heqichen/qc40/structure/shell/process1.png

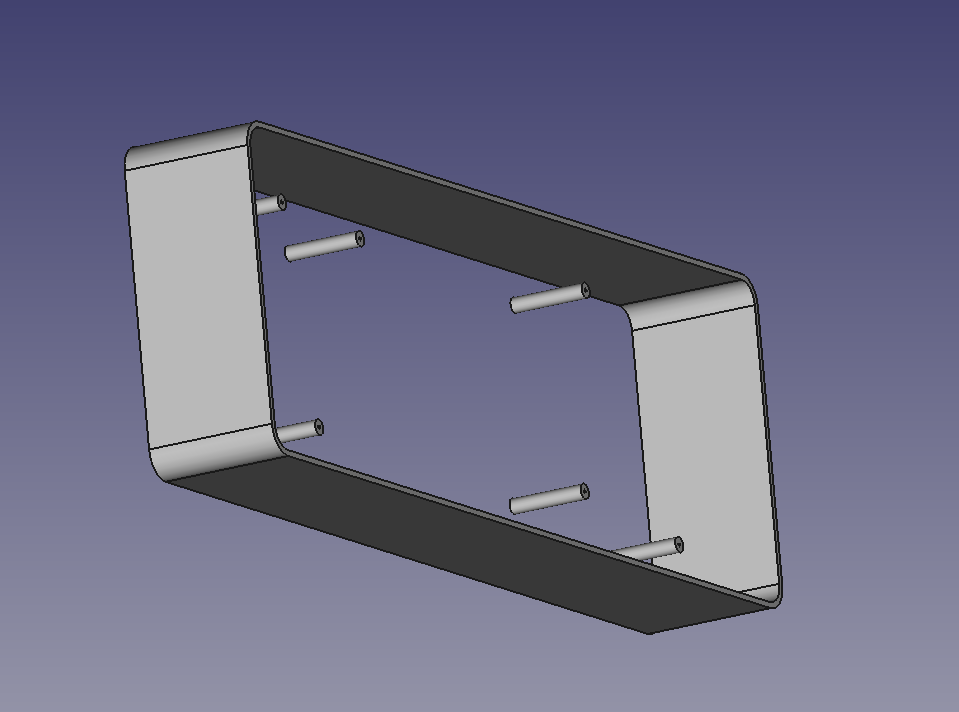
structure/shell/process1.png
