heqichen/qc40/andon/README.md

1. #1 can transmit message and print what transitted
2. #0 can receive data and check what received
