heqichen/qc40/document/usbdacpcm2704sch.png

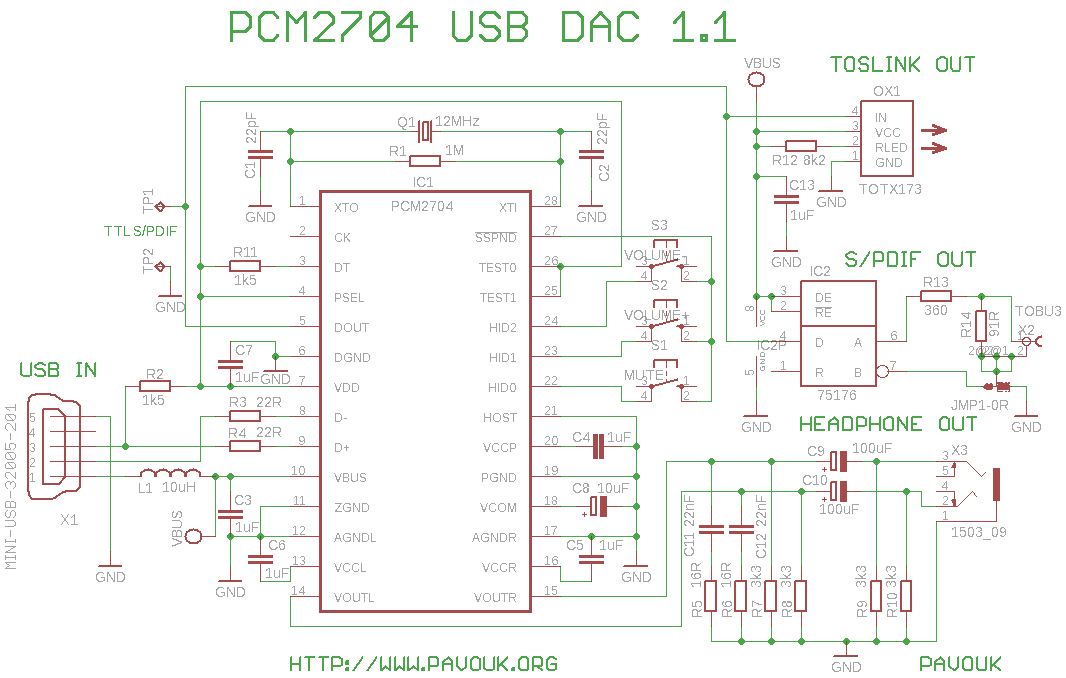
document/usbdacpcm2704sch.png
