heqichen/qc40/document/y2JtpHl.png

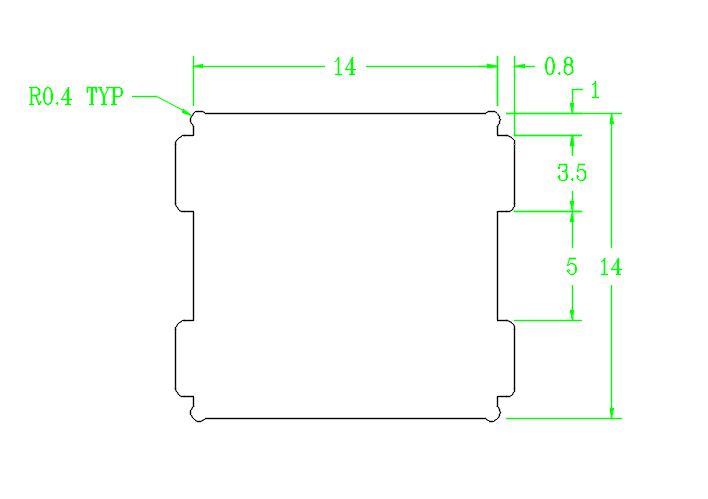
document/y2JtpHl.png
