heqichen/qc40/tu40.png

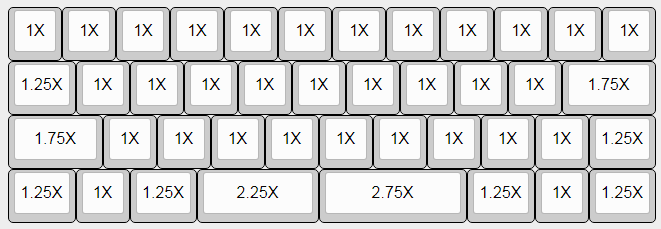
tu40.png
