heqichen/qc40/structure/shell.dxf

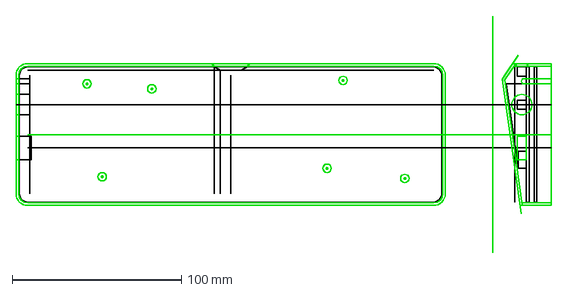
[picture p8: CAD file, 2018-02-18]
structure/shell.dxf
316.5 x 140.0 mm
