heqichen/qc40/structure/shell/shell.fcstd

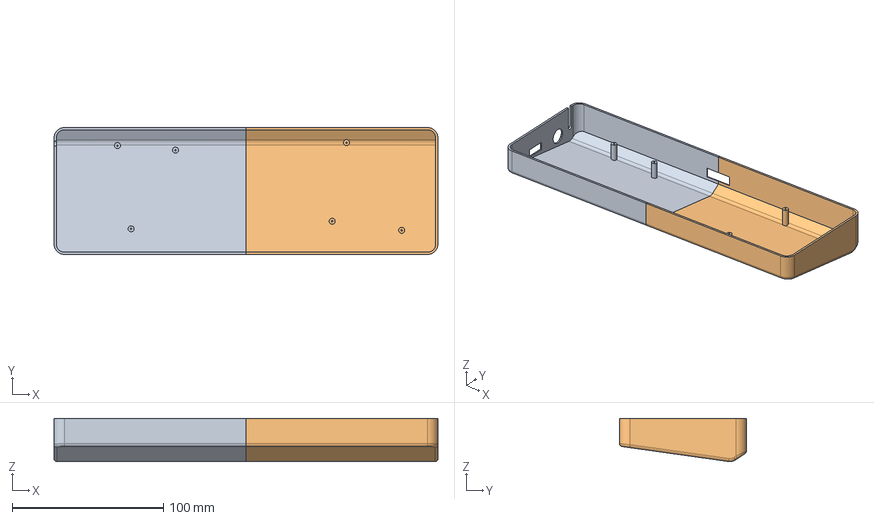
[picture p9: CAD file, 2018-02-18]
structure/shell/shell.fcstd
254.0 x 84.0 x 28.6 mm
shell-left
shell-right
