heqichen/qc40/structure/print-20170824.dxf

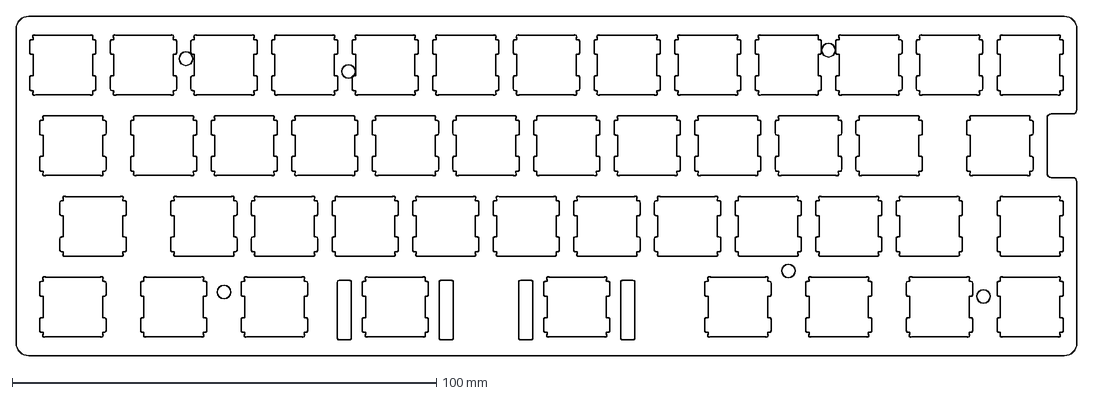
[picture p10: CAD file, 2017-09-01]
structure/print-20170824.dxf
250.0 x 80.0 mm
