heqichen/qc40/structure/h4k1.dxf

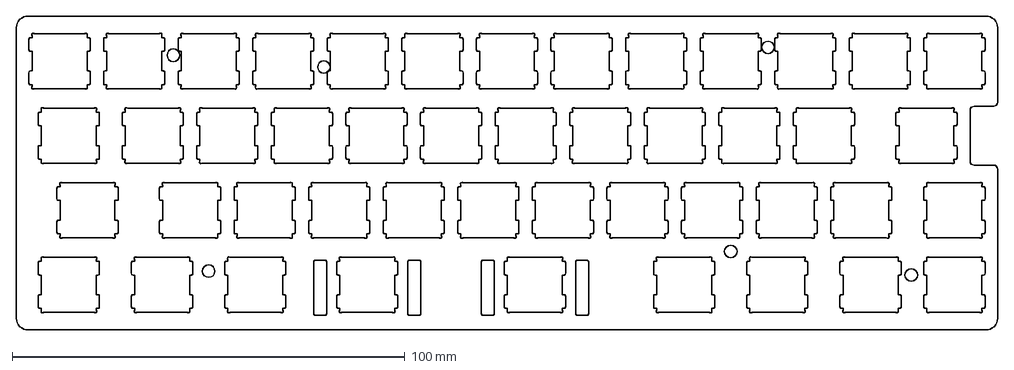
[picture p11: CAD file, 2017-08-23]
structure/h4k1.dxf
250.0 x 80.0 mm
