heqichen/qc40/structure/shell/shell-backup1.fcstd

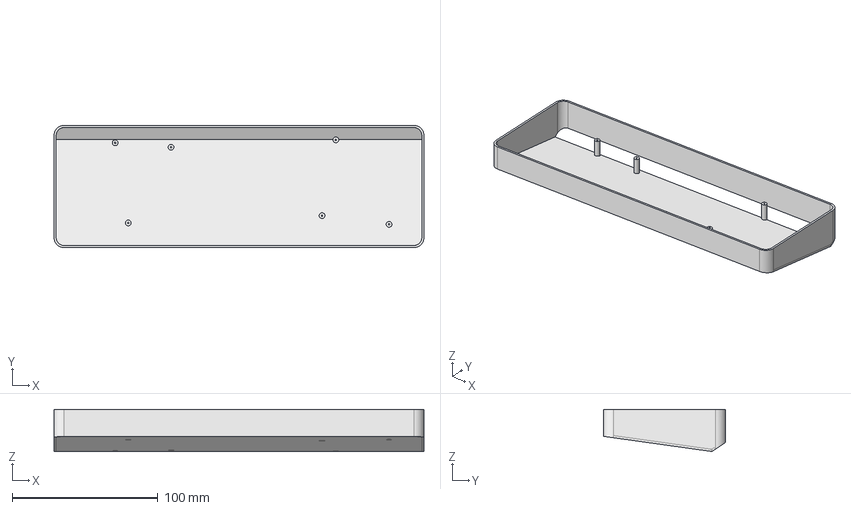
[picture p12: CAD file, 2018-02-18]
structure/shell/shell-backup1.fcstd
254.0 x 84.0 x 28.9 mm
