heqichen/qc40/structure/shell/shell-backup4.fcstd

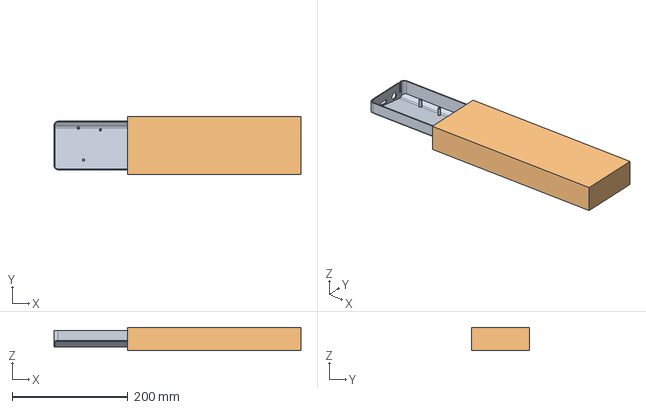
[picture p13: CAD file, 2018-02-18]
structure/shell/shell-backup4.fcstd
427.0 x 100.0 x 40.0 mm
