heqichen/qc40/structure/shell/shell-left.stl

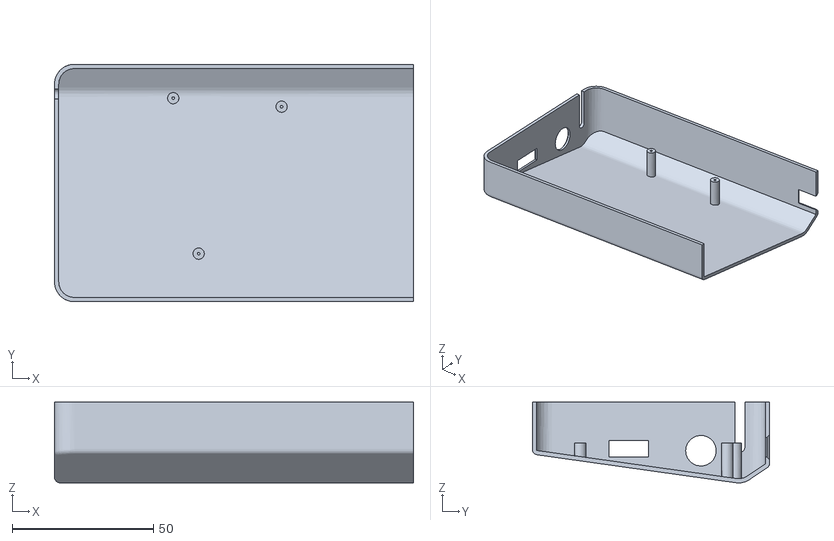
[picture p14: CAD file, 2018-02-18]
structure/shell/shell-left.stl
127.0 x 84.0 x 28.6
