heqichen/qc40/structure/shell/shell-backup5.fcstd

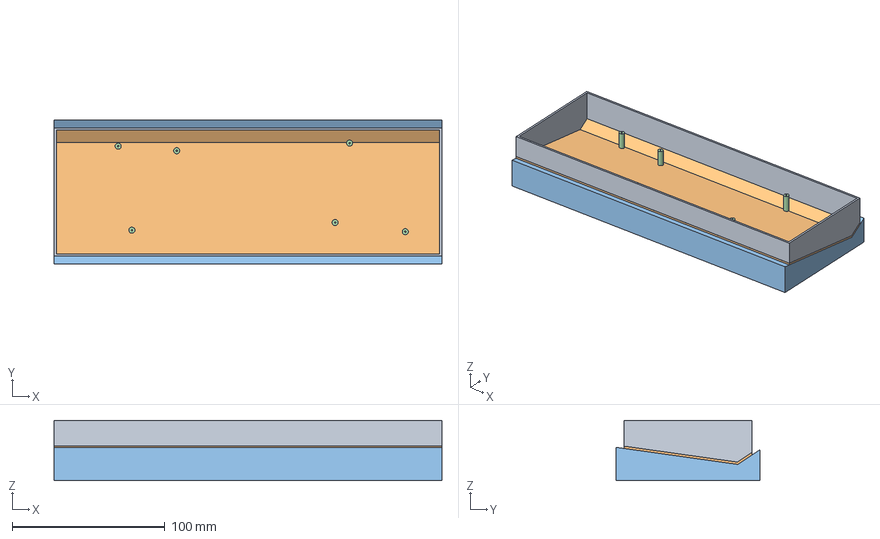
[picture p15: CAD file, 2018-02-18]
structure/shell/shell-backup5.fcstd
254.0 x 94.0 x 39.5 mm
外框Pad
大底pad
底阴模pad
