heqichen/qc40/(list of files, cad)

Other CAD files:
structure/shell/shell-backup3.fcstd
structure/shell/shell-backup2.fcstd
structure/shell/shell-right.stl
structure/shell/shell-backup6.fcstd
structure/shell/shell.stl
