heqichen/qc40/h4k1/h4k1.brd

## EAGLE design h4k1/h4k1.brd (2017-08-19)

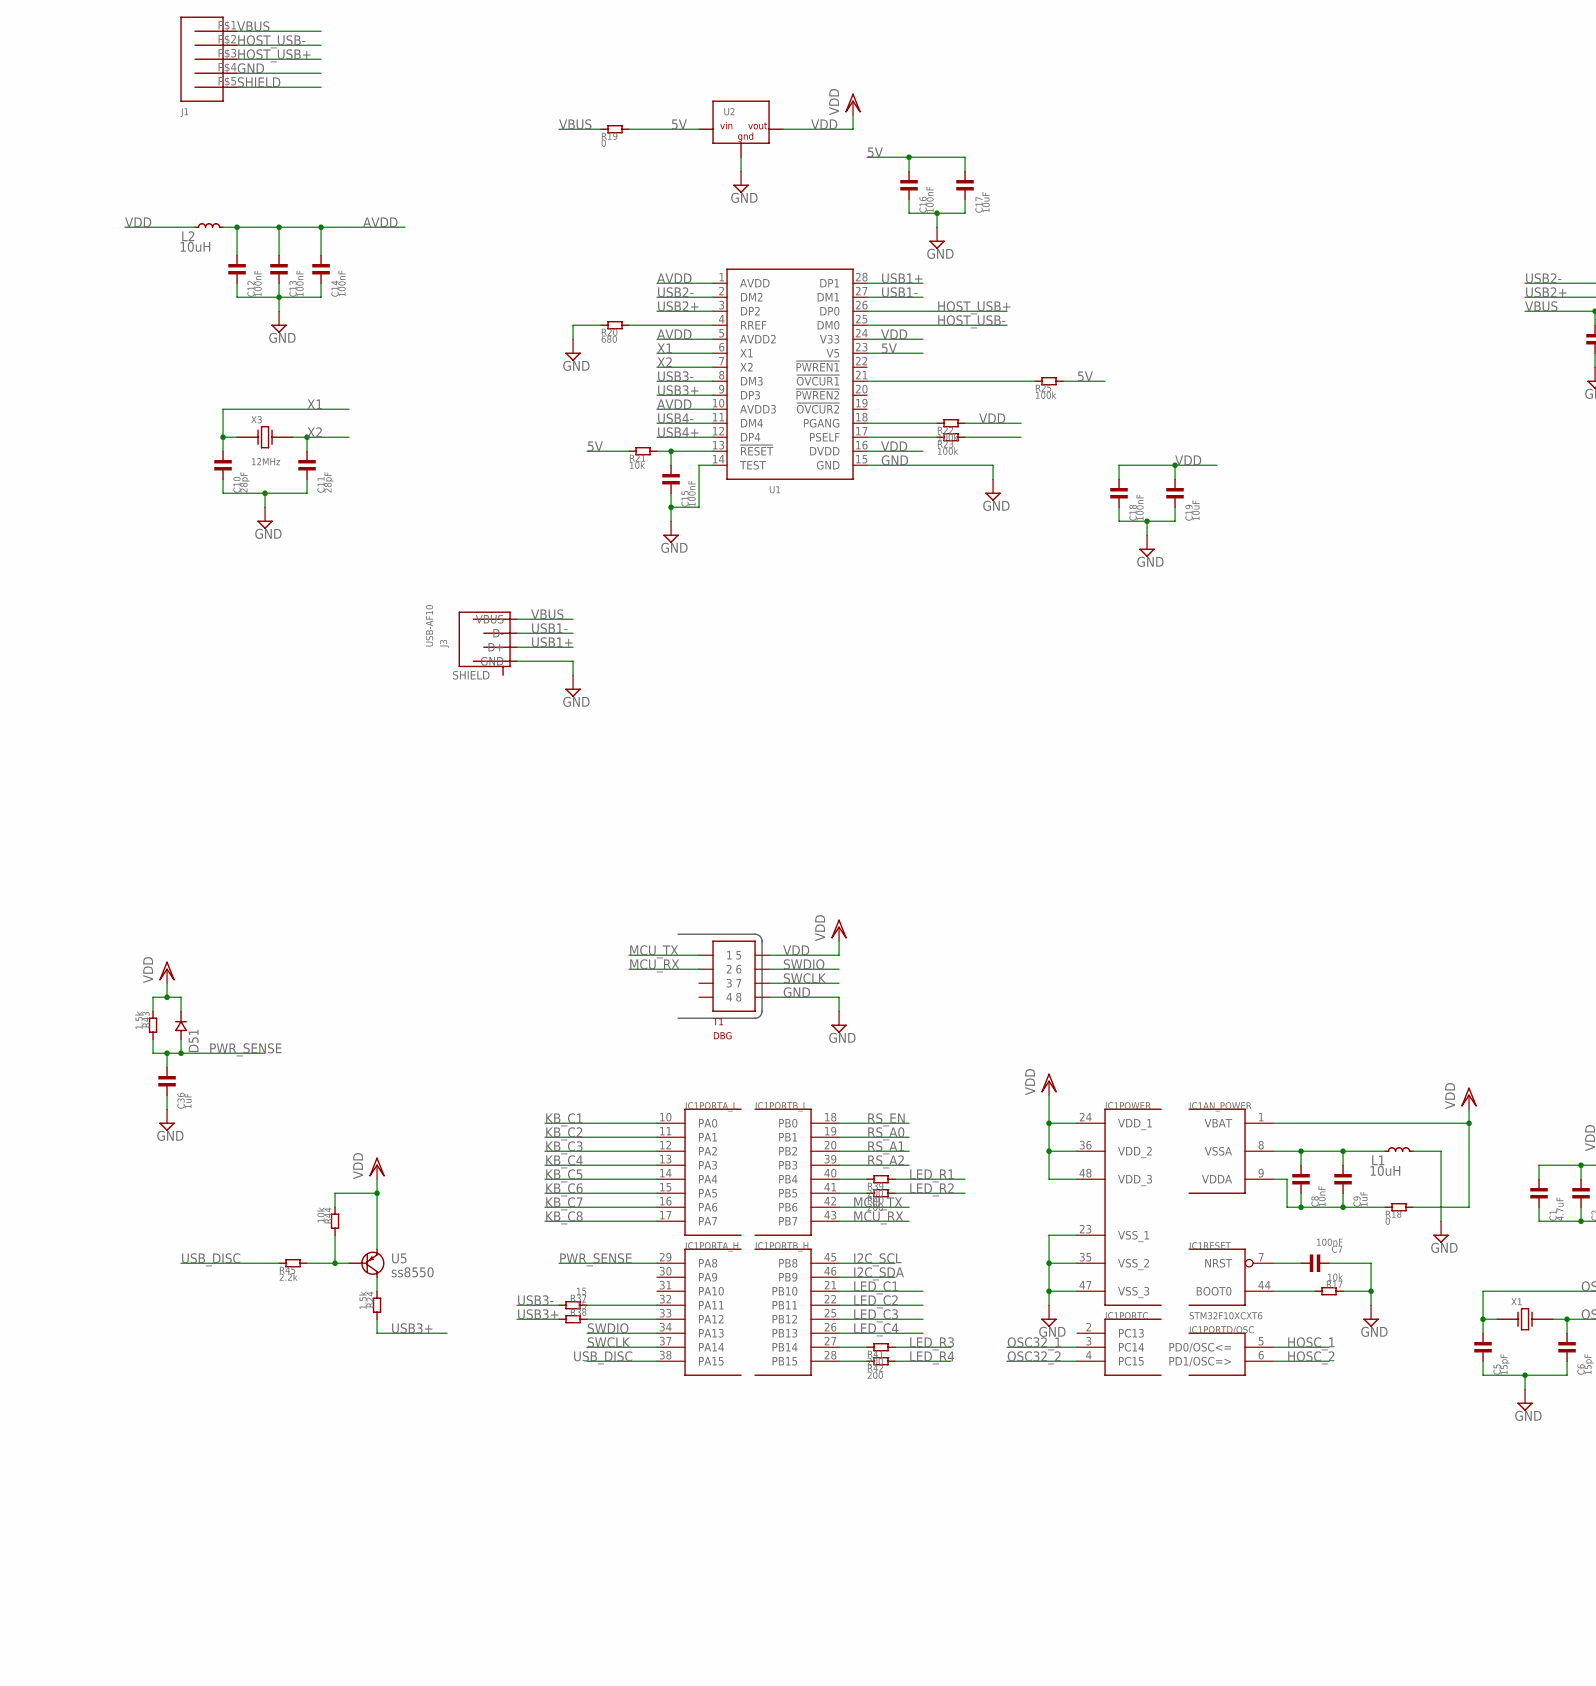
[picture p16: schematic h4k1.sch, part in row 1, column 1]

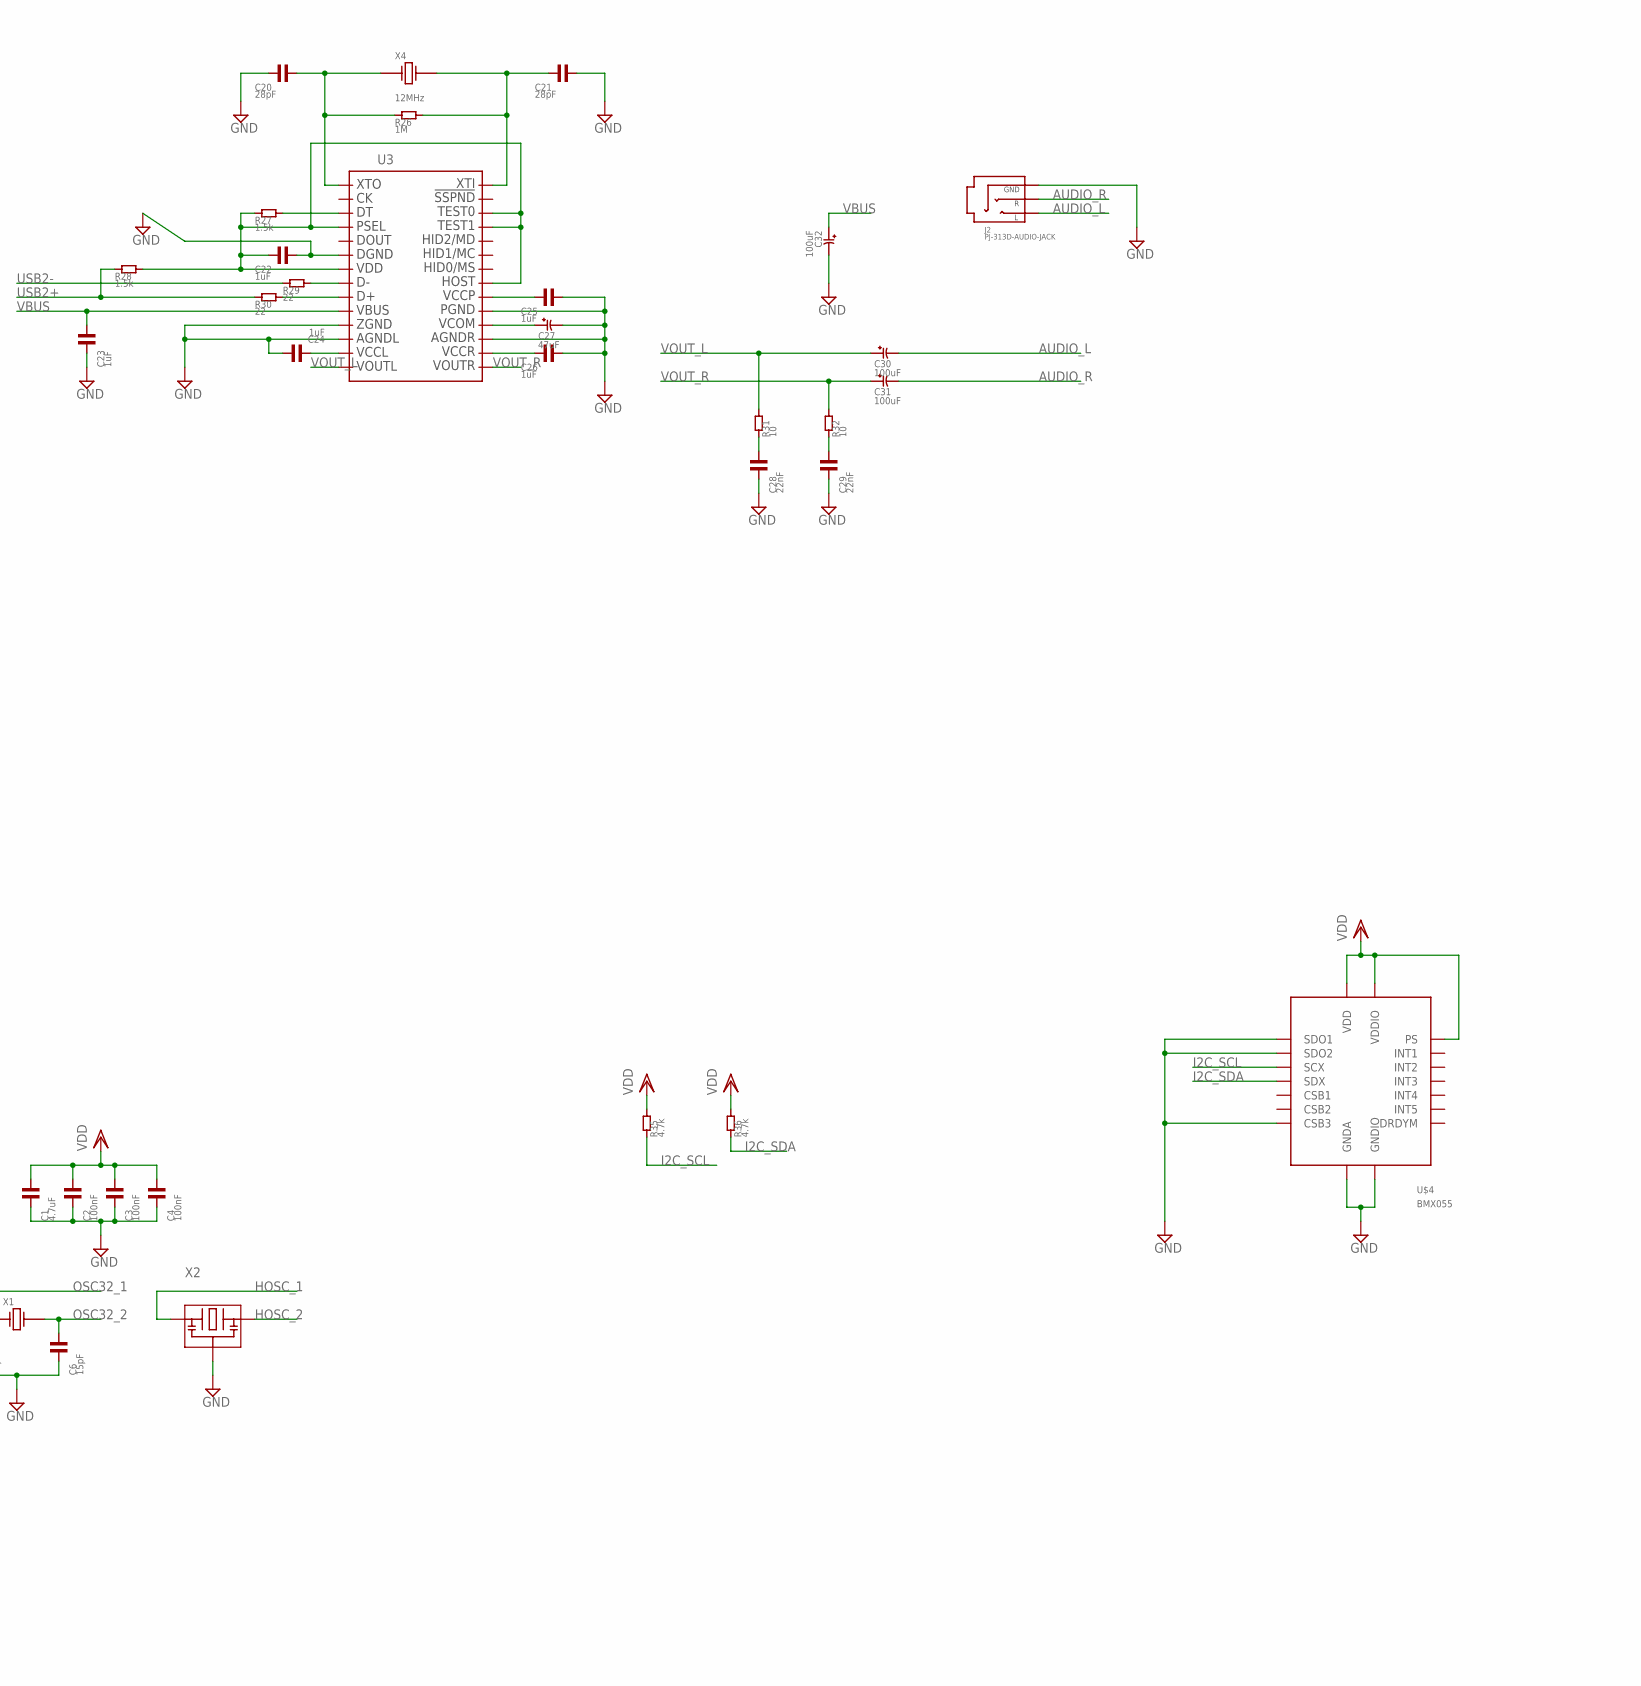
[picture p17: schematic h4k1.sch, part in row 1, column 2]

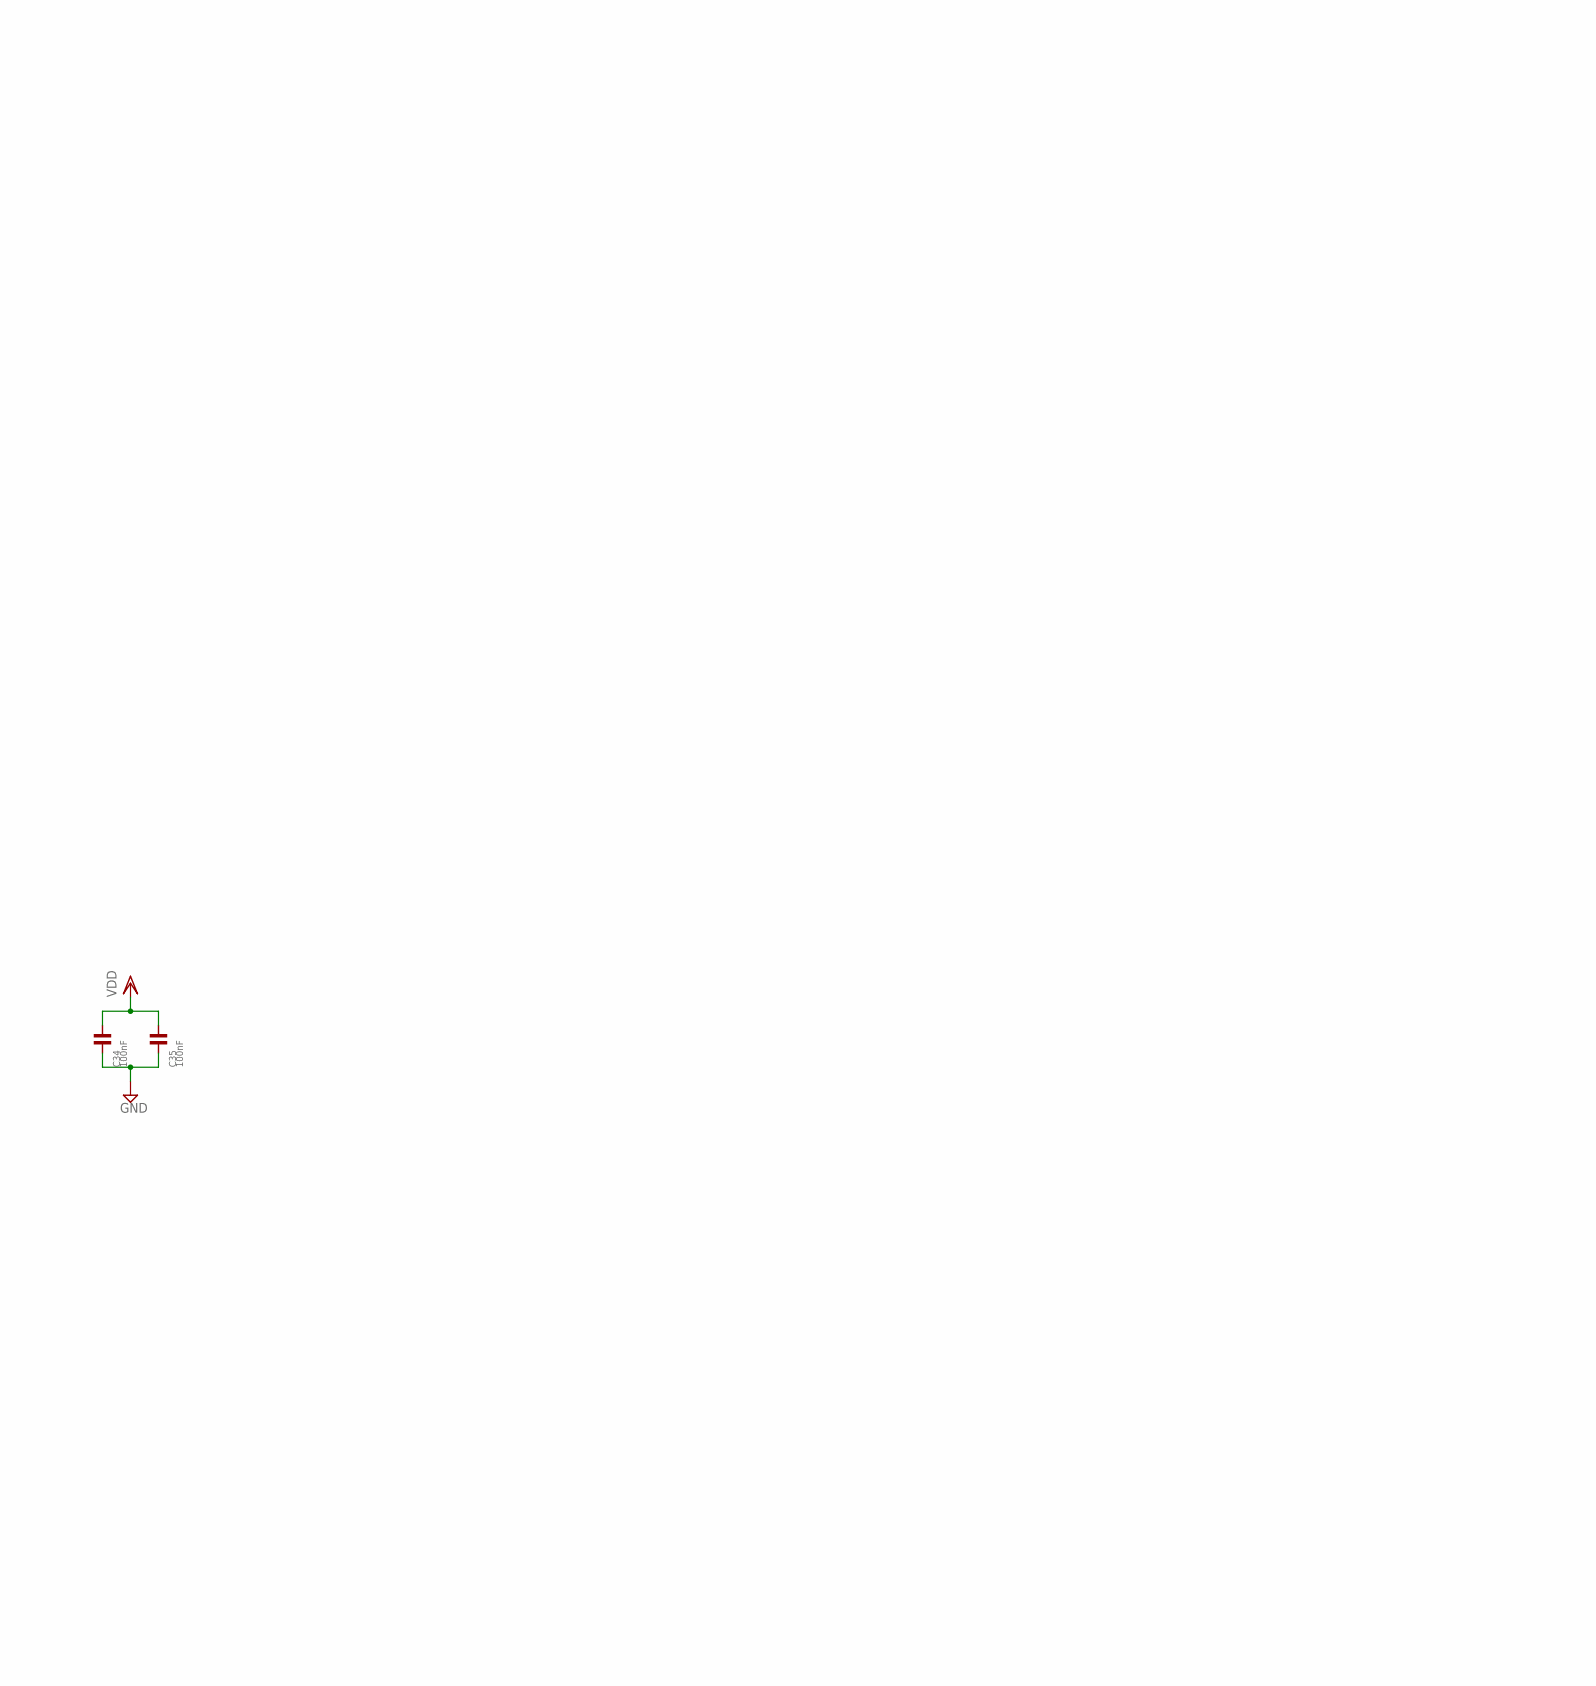
[picture p18: schematic h4k1.sch, part in row 1, column 3]

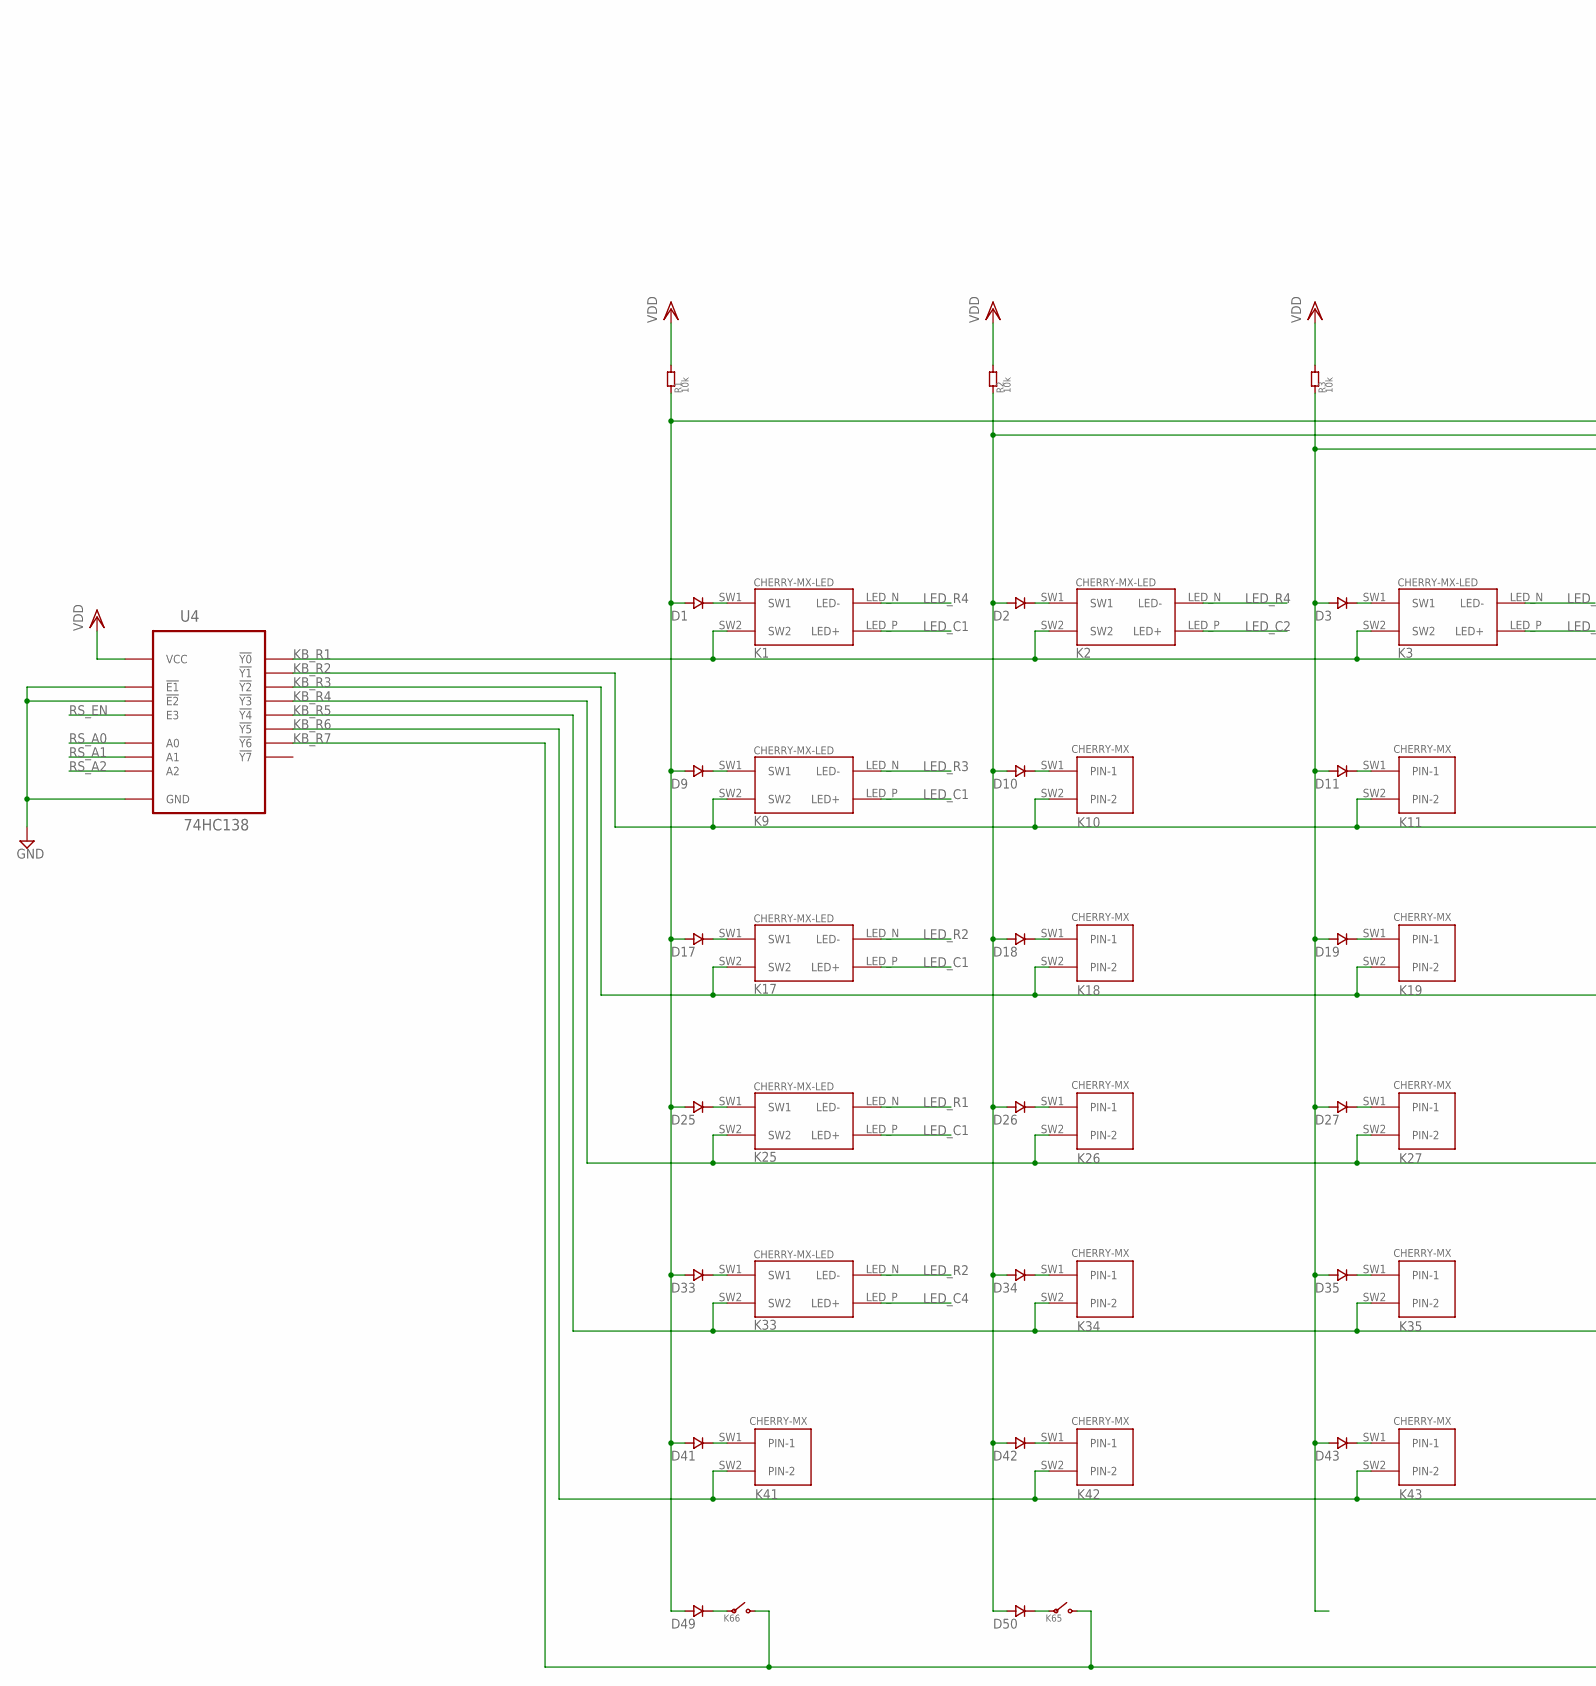
[picture p19: schematic h4k1.sch, part in row 2, column 1]

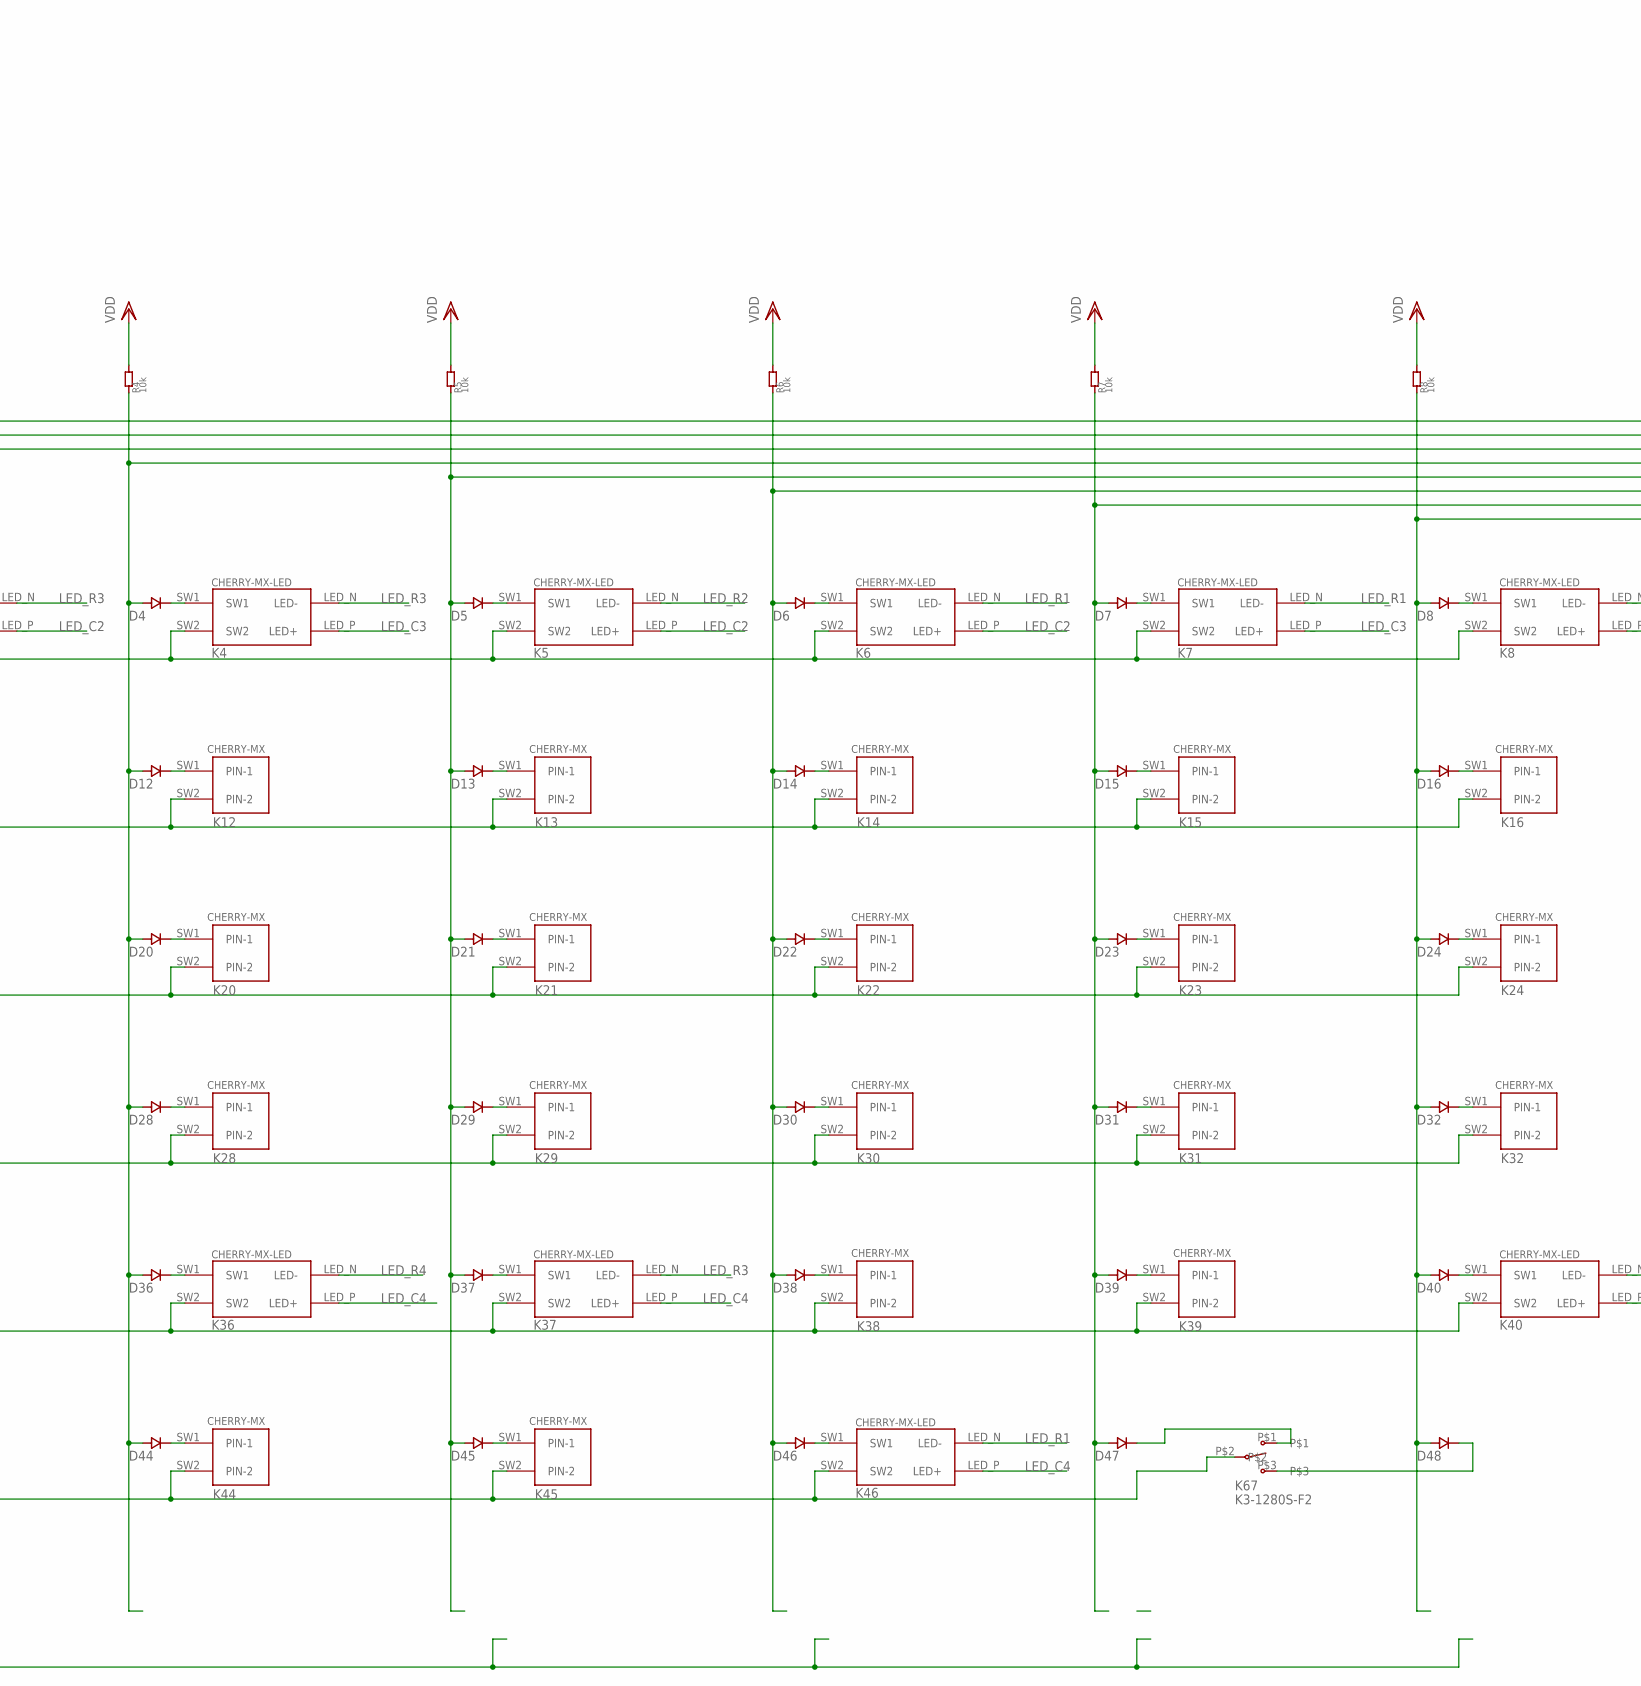
[picture p20: schematic h4k1.sch, part in row 2, column 2]

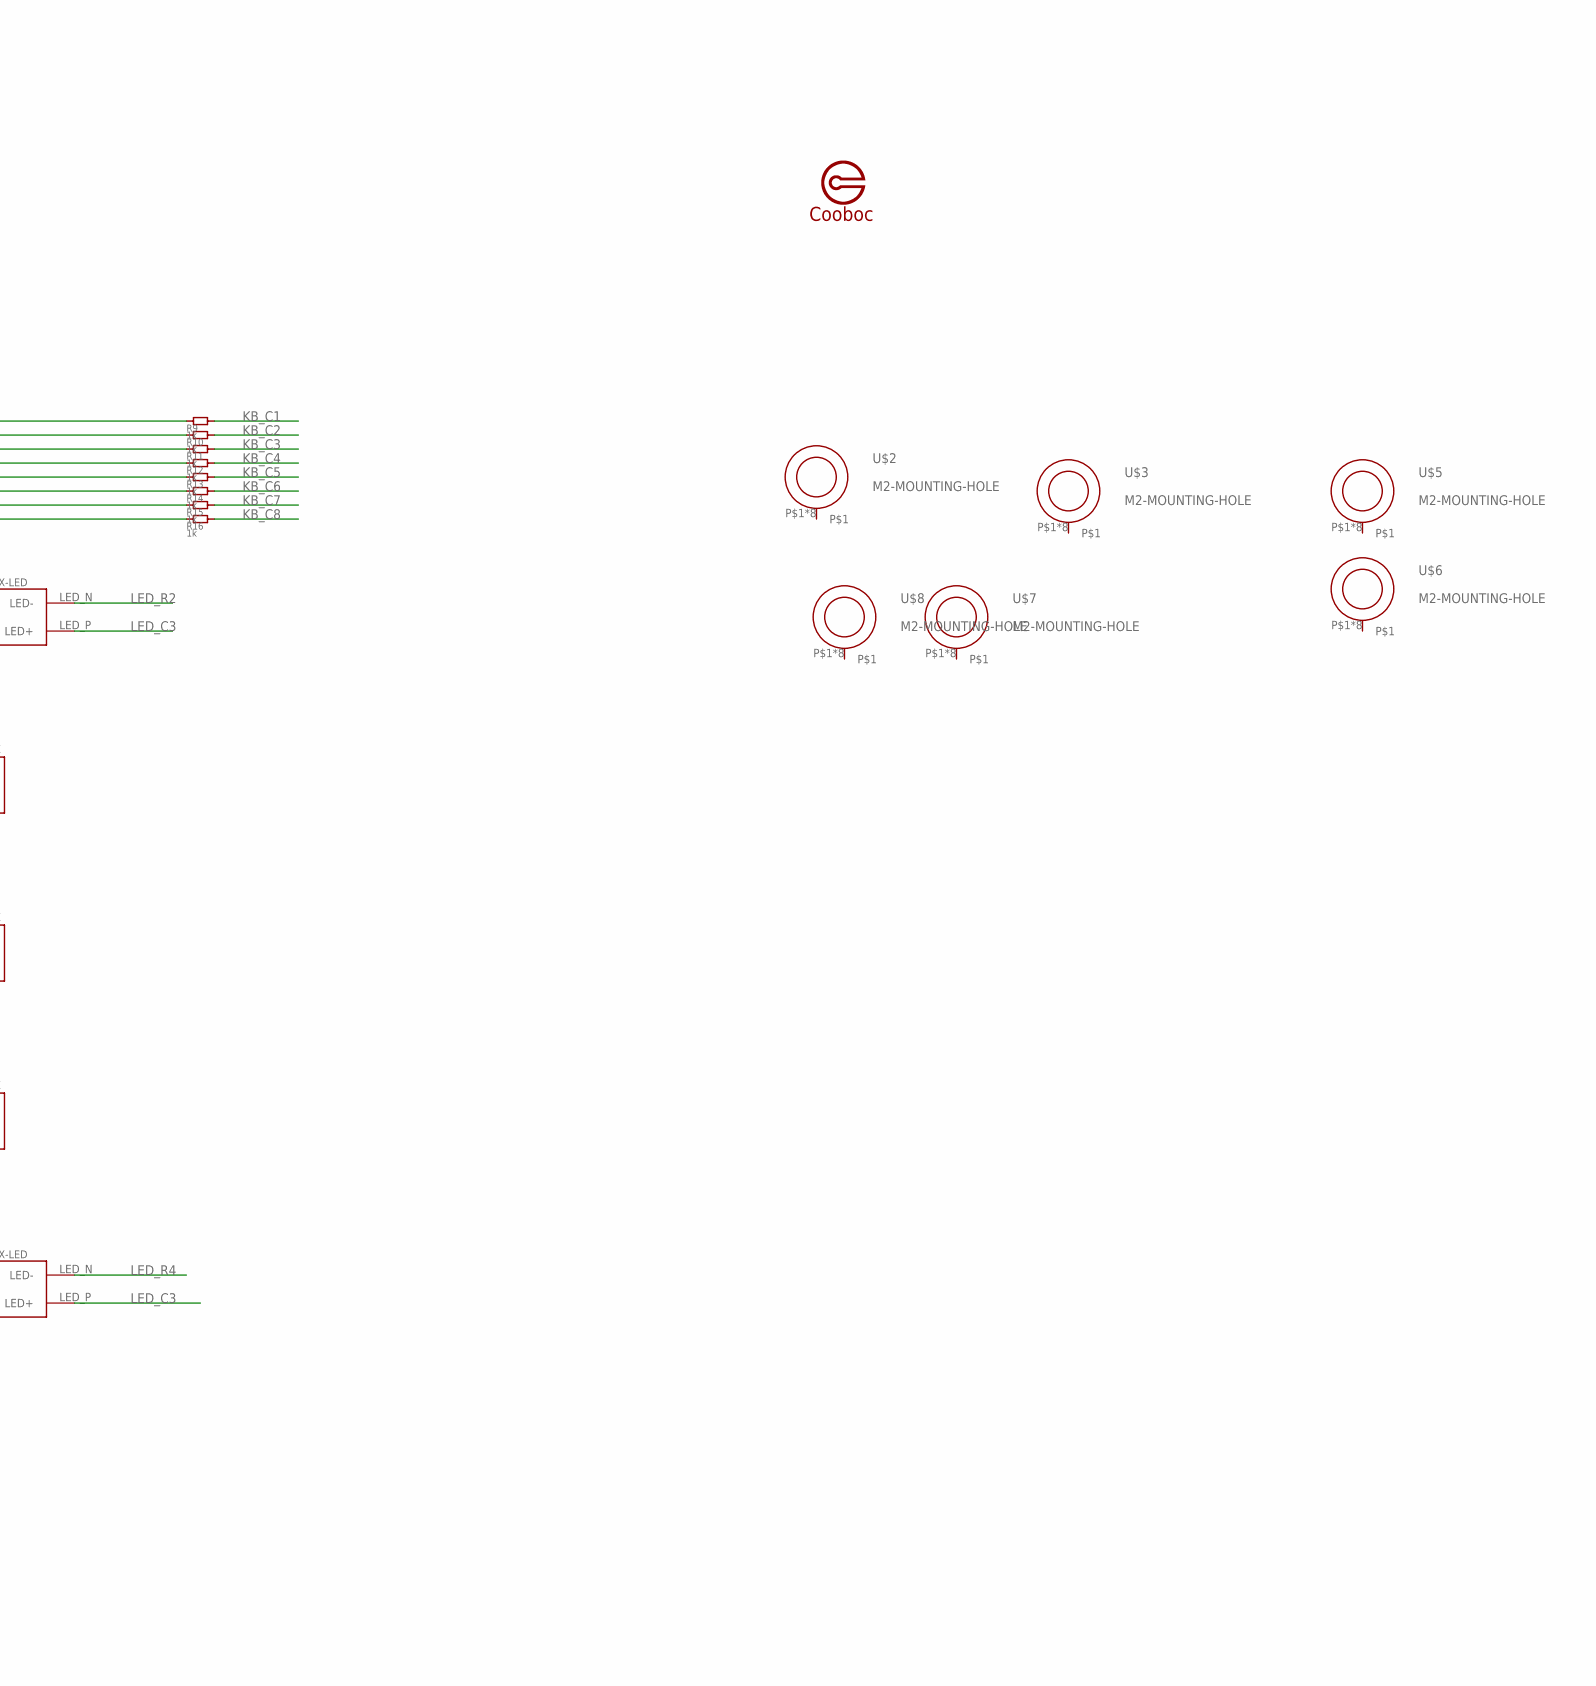
[picture p21: schematic h4k1.sch, part in row 2, column 3]

Parts:
C1: 4.7uF; 0805
C2, C3, C4, C7, C12, C13, C14, C15, C16, C18, C34, C35: 100nF; 0805
C5, C6: 15pF; 0805
C8: 10nF; 0805
C9, C22, C23, C24, C25, C26, C36: 1uF; 0805
C10, C11, C20, C21: 28pF; 0805
C17, C19: 10uF; 0805
C27: 47uF; CPOL-6.3X5.4
C28, C29: 22nF; 0805
C30, C31, C32: 100uF; CPOL-6.3X5.4
D1, D2, D3, D4, D5, D6, D7, D8, D9, D10, D11, D12, D13, D14, D15, D16, D17, D18, D19, D20, D21, D22, D23, D24, D25, D26, D27, D28, D29, D30, D31, D32, D33, D34, D35, D36, D37, D38, D39, D40, D41, D42, D43, D44, D45, D46, D47, D48, D49, D50, D51: IN4148WS-SWITCHING-DIODE; SOD-323
IC1: STM32F10XCXT6; TQFP48
J1: PH-5AWD
J2: PJ-313D-AUDIO-JACK; PJ-313D
J3: USB-AF10
K1, K2, K3, K4, K5, K6, K7, K8, K9, K17, K25, K33, K36, K37, K40, K46: CHERRY-MX-LED
K10, K11, K12, K13, K14, K15, K16, K18, K19, K20, K21, K22, K23, K24, K26, K27, K28, K29, K30, K31, K32, K34, K35, K38, K39, K41, K42, K43, K44, K45: CHERRY-MX
K65, K66: EVQPUL02K; EVQPUL
K67: K3-1280S-F2
L1, L2: 10uH; 0805
R1, R2, R3, R4, R5, R6, R7, R8, R17, R21, R44: 10k; 0805
R9, R10, R11, R12, R13, R14, R15, R16: 1k; 0805
R18, R19: 0; 0805
R20: 680; 0805
R22, R23, R25: 100k; 0805
R24, R27, R28, R43: 1.5k; 0805
R26: 1M; 0805
R29, R30: 22; 0805
R31, R32: 10; 0805
R35, R36: 4.7k; 0805
R37, R38: 15; 0805
R39, R40, R41, R42: 200; 0805
R45: 2.2k; 0805
T1: DBG; CLIP-8P-1.27
U1: GL850G; SSOP28
U2: AMS1117-33; SOT223
U3: PCM2704CDB; SSOP28
U4: 74HC138; SSOP16-208MIL
U5: ss8550; SOT-323
U$1: COOBOC-PLACE
U$2, U$3, U$5, U$6, U$7, U$8: M2-MOUNTING-HOLE
U$4: BMX055
X1: FC-12M-32.768; CRYSTAL-2012
X2: CSTCC8M00G53-R0-7230-8M-15P-RESONATOR; 7230-RESONATOR
X3, X4: 12MHz; 49S

Connections:
5V: C16.P$2, C17.P$2, R19.P$2, R21.P$1, R23.P$2, R25.P$2, U1.23 (V5), U2.3 (VIN)
AUDIO_L: C30.P$2, J2.P3, J2.P3@2
AUDIO_R: C31.P$2, J2.P2, J2.P2@2
AVDD: C12.P$2, C13.P$2, C14.P$2, L2.P$2, U1.1 (AVDD), U1.5 (AVDD2), U1.10 (AVDD3)
GND: C1.P$1, C2.P$1, C3.P$1, C4.P$1, C5.P$1, C6.P$1, C7.P$1, C10.P$1, C11.P$1, C12.P$1, C13.P$1, C14.P$1, C15.P$1, C16.P$1, C17.P$1, C18.P$1, C19.P$1, C20.P$1, C21.P$2, C22.P$2, C23.P$1, C24.P$2, C25.P$2, C26.P$2, C27.P$2, C28.P$1, C29.P$1, C32.P$2, C34.P$1, C35.P$1, C36.P$1, IC1.23 (VSS_1), IC1.35 (VSS_2), IC1.47 (VSS_3), J1.P$4, J2.P1, J2.P1@2, J3.P$G (GND), L1.P$2, R17.P$1, R20.P$1, T1.P$8 (8), U1.14 (TEST), U1.15 (GND), U2.1 (GND), U3.6, U3.11, U3.12, U3.17, U3.19, U4.P$4 (!E1), U4.P$5 (!E2), U4.P$8 (GND), U$4.P$4 (GNDA), U$4.P$6 (GNDIO), U$4.P$12 (SDO2), U$4.P$17 (SDO1), U$4.P$20 (CSB3), X2.P$2
HOSC_1: IC1.5 (PD0/OSC<=), X2.P$1
HOSC_2: IC1.6 (PD1/OSC=>), X2.P$3
HOST_USB+: J1.P$3, U1.26 (DP0)
HOST_USB-: J1.P$2, U1.25 (DM0)
I2C_SCL: IC1.45 (PB8), R35.P$1, U$4.P$9 (SCX)
I2C_SDA: IC1.46 (PB9), R36.P$1, U$4.P$11 (SDX)
KB_C1: IC1.10 (PA0), R9.P$2
KB_C2: IC1.11 (PA1), R10.P$2
KB_C3: IC1.12 (PA2), R11.P$2
KB_C4: IC1.13 (PA3), R12.P$2
KB_C5: IC1.14 (PA4), R13.P$2
KB_C6: IC1.15 (PA5), R14.P$2
KB_C7: IC1.16 (PA6), R15.P$2
KB_C8: IC1.17 (PA7), R16.P$2
KB_R1: K1.SW2, K2.SW2, K3.SW2, K4.SW2, K5.SW2, K6.SW2, K7.SW2, K8.SW2, U4.P$15 (!Y0)
KB_R2: K9.SW2, K10.SW2 (PIN-2), K11.SW2 (PIN-2), K12.SW2 (PIN-2), K13.SW2 (PIN-2), K14.SW2 (PIN-2), K15.SW2 (PIN-2), K16.SW2 (PIN-2), U4.P$14 (!Y1)
KB_R3: K17.SW2, K18.SW2 (PIN-2), K19.SW2 (PIN-2), K20.SW2 (PIN-2), K21.SW2 (PIN-2), K22.SW2 (PIN-2), K23.SW2 (PIN-2), K24.SW2 (PIN-2), U4.P$13 (!Y2)
KB_R4: K25.SW2, K26.SW2 (PIN-2), K27.SW2 (PIN-2), K28.SW2 (PIN-2), K29.SW2 (PIN-2), K30.SW2 (PIN-2), K31.SW2 (PIN-2), K32.SW2 (PIN-2), U4.P$12 (!Y3)
KB_R5: K33.SW2, K34.SW2 (PIN-2), K35.SW2 (PIN-2), K36.SW2, K37.SW2, K38.SW2 (PIN-2), K39.SW2 (PIN-2), K40.SW2, U4.P$11 (!Y4)
KB_R6: K41.SW2 (PIN-2), K42.SW2 (PIN-2), K43.SW2 (PIN-2), K44.SW2 (PIN-2), K45.SW2 (PIN-2), K46.SW2, K67.P$2, U4.P$10 (!Y5)
KB_R7: K65.P$2, K65.P$4, K66.P$2, K66.P$4, U4.P$9 (!Y6)
LED_C1: IC1.21 (PB10), K1.LED_P (LED+), K9.LED_P (LED+), K17.LED_P (LED+), K25.LED_P (LED+)
LED_C2: IC1.22 (PB11), K2.LED_P (LED+), K3.LED_P (LED+), K5.LED_P (LED+), K6.LED_P (LED+)
LED_C3: IC1.25 (PB12), K4.LED_P (LED+), K7.LED_P (LED+), K8.LED_P (LED+), K40.LED_P (LED+)
LED_C4: IC1.26 (PB13), K33.LED_P (LED+), K36.LED_P (LED+), K37.LED_P (LED+), K46.LED_P (LED+)
LED_R1: K6.LED_N (LED-), K7.LED_N (LED-), K25.LED_N (LED-), K46.LED_N (LED-), R39.P$2
LED_R2: K5.LED_N (LED-), K8.LED_N (LED-), K17.LED_N (LED-), K33.LED_N (LED-), R40.P$2
LED_R3: K3.LED_N (LED-), K4.LED_N (LED-), K9.LED_N (LED-), K37.LED_N (LED-), R41.P$2
LED_R4: K1.LED_N (LED-), K2.LED_N (LED-), K36.LED_N (LED-), K40.LED_N (LED-), R42.P$2
MCU_RX: IC1.43 (PB7), T1.P$2 (2)
MCU_TX: IC1.42 (PB6), T1.P$1 (1)
unnamed: D1.P$2, K1.SW1
unnamed: D1.P$1, D9.P$1, D17.P$1, D25.P$1, D33.P$1, D41.P$1, D49.P$1, R1.P$1, R9.P$1
unnamed: D9.P$2, K9.SW1
unnamed: D2.P$2, K2.SW1
unnamed: D2.P$1, D10.P$1, D18.P$1, D26.P$1, D34.P$1, D42.P$1, D50.P$1, R2.P$1, R10.P$1
unnamed: IC1.44 (BOOT0), R17.P$2
unnamed: D3.P$2, K3.SW1
unnamed: C8.P$2, C9.P$2, IC1.8 (VSSA), L1.P$1
unnamed: C7.P$2, IC1.7 (NRST)
unnamed: D4.P$2, K4.SW1
unnamed: D4.P$1, D12.P$1, D20.P$1, D28.P$1, D36.P$1, D44.P$1, R4.P$1, R12.P$1
unnamed: D5.P$2, K5.SW1
unnamed: D5.P$1, D13.P$1, D21.P$1, D29.P$1, D37.P$1, D45.P$1, R5.P$1, R13.P$1
unnamed: D6.P$2, K6.SW1
unnamed: D6.P$1, D14.P$1, D22.P$1, D30.P$1, D38.P$1, D46.P$1, R6.P$1, R14.P$1
unnamed: D7.P$2, K7.SW1
unnamed: D7.P$1, D15.P$1, D23.P$1, D31.P$1, D39.P$1, D47.P$1, R7.P$1, R15.P$1
unnamed: D10.P$2, K10.SW1 (PIN-1)
unnamed: D8.P$2, K8.SW1
unnamed: D8.P$1, D16.P$1, D24.P$1, D32.P$1, D40.P$1, D48.P$1, R8.P$1, R16.P$1
unnamed: C8.P$1, C9.P$1, IC1.9 (VDDA), R18.P$1
unnamed: D11.P$2, K11.SW1 (PIN-1)
unnamed: D3.P$1, D11.P$1, D19.P$1, D27.P$1, D35.P$1, D43.P$1, R3.P$1, R11.P$1
unnamed: C15.P$2, R21.P$2, U1.13 (!RESET)
unnamed: D12.P$2, K12.SW1 (PIN-1)
unnamed: R20.P$2, U1.4 (RREF)
unnamed: D13.P$2, K13.SW1 (PIN-1)
unnamed: R22.P$1, U1.18 (PGANG)
unnamed: D14.P$2, K14.SW1 (PIN-1)
unnamed: R23.P$1, U1.17 (PSELF)
unnamed: D15.P$2, K15.SW1 (PIN-1)
unnamed: C20.P$2, R26.P$1, U3.1, X4.P$1
unnamed: D16.P$2, K16.SW1 (PIN-1)
unnamed: R25.P$1, U1.21 (!OVCUR1)
unnamed: D17.P$2, K17.SW1
unnamed: C21.P$1, R26.P$2, U3.28, X4.P$2
unnamed: D18.P$2, K18.SW1 (PIN-1)
unnamed: R29.P$2, U3.8
unnamed: D19.P$2, K19.SW1 (PIN-1)
unnamed: R30.P$2, U3.9
unnamed: D20.P$2, K20.SW1 (PIN-1)
unnamed: C22.P$1, R27.P$1, R28.P$2, U3.4, U3.7, U3.21, U3.25, U3.26
unnamed: D21.P$2, K21.SW1 (PIN-1)
unnamed: C25.P$1, U3.20
unnamed: D22.P$2, K22.SW1 (PIN-1)
unnamed: D23.P$2, K23.SW1 (PIN-1)
unnamed: C24.P$1, U3.13
unnamed: D24.P$2, K24.SW1 (PIN-1)
unnamed: R27.P$2, U3.3
unnamed: D25.P$2, K25.SW1
unnamed: D26.P$2, K26.SW1 (PIN-1)
unnamed: D27.P$2, K27.SW1 (PIN-1)
unnamed: C26.P$1, U3.16
unnamed: C27.P$1, U3.18
unnamed: D28.P$2, K28.SW1 (PIN-1)
unnamed: D29.P$2, K29.SW1 (PIN-1)
unnamed: D30.P$2, K30.SW1 (PIN-1)
unnamed: D31.P$2, K31.SW1 (PIN-1)
unnamed: D32.P$2, K32.SW1 (PIN-1)
unnamed: D33.P$2, K33.SW1
unnamed: D34.P$2, K34.SW1 (PIN-1)
unnamed: C29.P$2, R32.P$1
unnamed: D35.P$2, K35.SW1 (PIN-1)
unnamed: C28.P$2, R31.P$1
unnamed: D36.P$2, K36.SW1
unnamed: D47.P$2, K67.P$1
unnamed: D37.P$2, K37.SW1
unnamed: D49.P$2, K66.P$1, K66.P$3
unnamed: D38.P$2, K38.SW1 (PIN-1)
unnamed: IC1.32 (PA11), R37.P$1
unnamed: D39.P$2, K39.SW1 (PIN-1)
unnamed: IC1.33 (PA12), R38.P$1
unnamed: D40.P$2, K40.SW1
unnamed: IC1.40 (PB4), R39.P$1
unnamed: D41.P$2, K41.SW1 (PIN-1)
unnamed: D42.P$2, K42.SW1 (PIN-1)
unnamed: D43.P$2, K43.SW1 (PIN-1)
unnamed: IC1.41 (PB5), R40.P$1
unnamed: IC1.28 (PB15), R42.P$1
unnamed: D44.P$2, K44.SW1 (PIN-1)
unnamed: D45.P$2, K45.SW1 (PIN-1)
unnamed: D46.P$2, K46.SW1
unnamed: IC1.27 (PB14), R41.P$1
unnamed: D48.P$2, K67.P$3
unnamed: R44.P$2, R45.P$2, U5.P$1 (P$B)
unnamed: D50.P$2, K65.P$1, K65.P$3
unnamed: R24.P$1, U5.P$3 (P$C)
OSC32_1: C5.P$2, IC1.3 (PC14), X1.P$1
OSC32_2: C6.P$2, IC1.4 (PC15), X1.P$2
PWR_SENSE: C36.P$2, D51.P$1, IC1.29 (PA8), R43.P$2
RS_A0: IC1.19 (PB1), U4.P$1 (A0)
RS_A1: IC1.20 (PB2), U4.P$2 (A1)
RS_A2: IC1.39 (PB3), U4.P$3 (A2)
RS_EN: IC1.18 (PB0), U4.P$6 (E3)
SHIELD: J1.P$5
SWCLK: IC1.37 (PA14), T1.P$7 (7)
SWDIO: IC1.34 (PA13), T1.P$6 (6)
USB1+: J3.P$D+ (D+), U1.28 (DP1)
USB1-: J3.P$D- (D-), U1.27 (DM1)
USB2+: R28.P$1, R30.P$1, U1.3 (DP2)
USB2-: R29.P$1, U1.2 (DM2)
USB3+: R24.P$2, R38.P$2, U1.9 (DP3)
USB3-: R37.P$2, U1.8 (DM3)
USB4+: U1.12 (DP4)
USB4-: U1.11 (DM4)
USB_DISC: IC1.38 (PA15), R45.P$1
VBUS: C23.P$2, C32.P$1, J1.P$1, J3.P$V (VBUS), R19.P$1, U3.10
VDD: C1.P$2, C2.P$2, C3.P$2, C4.P$2, C18.P$2, C19.P$2, C34.P$2, C35.P$2, D51.P$2, IC1.1 (VBAT), IC1.24 (VDD_1), IC1.36 (VDD_2), IC1.48 (VDD_3), L2.P$1, R1.P$2, R2.P$2, R3.P$2, R4.P$2, R5.P$2, R6.P$2, R7.P$2, R8.P$2, R18.P$2, R22.P$2, R35.P$2, R36.P$2, R43.P$1, R44.P$1, T1.P$5 (5), U1.16 (DVDD), U1.24 (V33), U2.2 (VOUT), U4.P$16 (VCC), U5.P$2 (P$E), U$4.P$3 (VDD), U$4.P$7 (PS), U$4.P$13 (VDDIO)
VOUT_L: C30.P$1, R31.P$2, U3.14
VOUT_R: C31.P$1, R32.P$2, U3.15
X1: C10.P$2, U1.6 (X1), X3.P$1
X2: C11.P$2, U1.7 (X2), X3.P$2

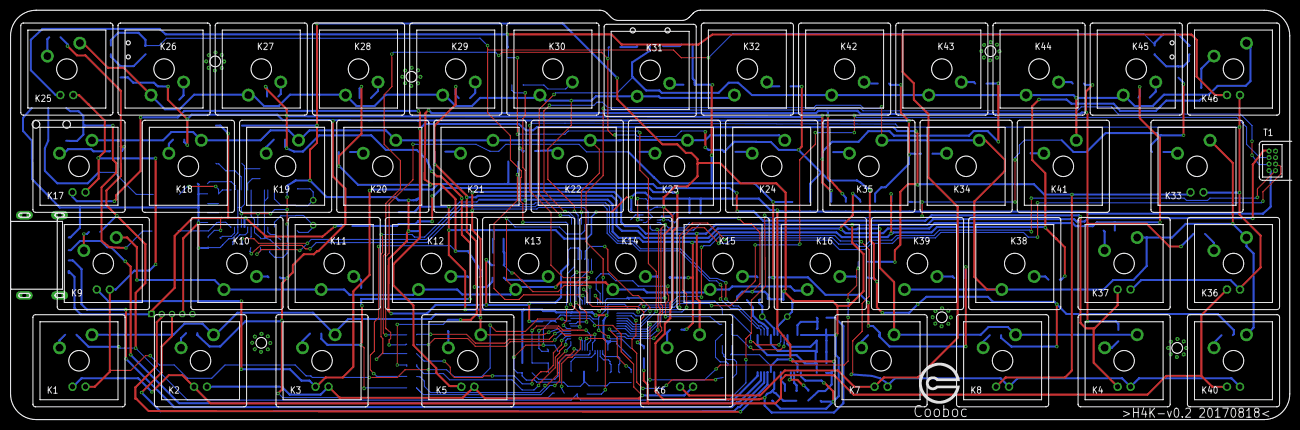
[picture p22: board h4k1.brd from above]

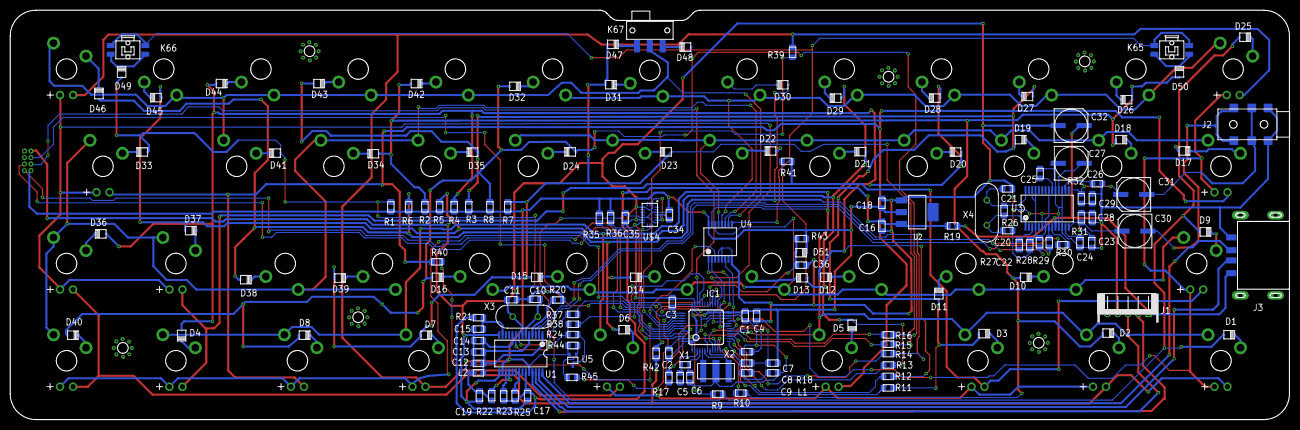
[picture p23: board h4k1.brd from below]

Board: 2 copper layers, 250.0 x 80.0 mm, 202 parts (148 on the bottom side), 145 nets.
