heqichen/qc40/andon/src/cooboc/gpio.h

#ifndef __GPIO_H__
#define __GPIO_H__


#include "stm32f10x.h"


#define A0  0
#define A1  1
#define A2  2
#define A3  3
#define A4  4
#define A5  5
#define A6  6
#define A7  7
#define A8  8
#define A9  9
#define A10 10
#define A11 11
#define A12 12
#define A13 13
#define A14 14
#define A15 15

#define B0  16
#define B1  17
#define B2  18
#define B3  19
#define B4  20
#define B5  21
#define B6  22
#define B7  23
#define B8  24
#define B9  25
#define B10 26
#define B11 27
#define B12 28
#define B13 29
#define B14 30
#define B15 31

#define C0  32
#define C1  33
#define C2  34
#define C3  35
#define C4  36
#define C5  37
#define C6  38
#define C7  39
#define C8  40
#define C9  41
#define C10 42
#define C11 43
#define C12 44
#define C13 45
#define C14 46
#define C15 47

#define D0  48
#define D1  49
#define D2  50
#define D3  51
#define D4  52
#define D5  53
#define D6  54
#define D7  55
#define D8  56
#define D9  57
#define D10 58
#define D11 59
#define D12 60
#define D13 61
#define D14 62
#define D15 63

#define E0  64
#define E1  65
#define E2  66
#define E3  67
#define E4  68
#define E5  69
#define E6  70
#define E7  71
#define E8  72
#define E9  73
#define E10 74
#define E11 75
#define E12 76
#define E13 77
#define E14 78
#define E15 79

#define F0  80
#define F1  81
#define F2  82
#define F3  83
#define F4  84
#define F5  85
#define F6  86
#define F7  87
#define F8  88
#define F9  89
#define F10 90
#define F11 91
#define F12 92
#define F13 93
#define F14 94
#define F15 95

#define G0  96
#define G1  97
#define G2  98
#define G3  99
#define G4  100
#define G5  101
#define G6  102
#define G7  103
#define G8  104
#define G9  105
#define G10 106
#define G11 107
#define G12 108
#define G13 109
#define G14 110
#define G15 111



#define INPUT_ANALOG			GPIO_Mode_AIN
#define INPUT_FLOATING			GPIO_Mode_IN_FLOATING
#define INPUT_PULL_DOWN			GPIO_Mode_IPD
#define INPUT_PULL_UP			GPIO_Mode_IPU

#define OUTPUT_OPEN_DRAIN		GPIO_Mode_Out_OD
#define OUTPUT_PUSH_PULL		GPIO_Mode_Out_PP

#define GPIO_MUX_OPEN_DRAIN		GPIO_Mode_AF_OD
#define GPIO_MUX_PUSH_PULL		GPIO_Mode_AF_PP

#define INPUT					INPUT_FLOATING
#define OUTPUT					OUTPUT_PUSH_PULL


#define LOW		0
#define HIGH	1


void pinMode(int pin, int mode);
void digitalWrite(int pin, int value);
int digitalRead(int pin);
int analogRead(int pin);

#endif
