heqichen/qc40/andon/src/event_loop.h

#ifndef __EVENT_LOOP_H__
#define __EVENT_LOOP_H__

#include "fifo.h"
#include "hid.h"
#include "interpreter.h"

#define EVENT_KEY_DOWN	0x01
#define EVENT_KEY_UP	0x02

class EventLoop
{
	public:
		void setup(Hid *hid, Interpreter *interpreter);
		void tick();
		void newEvent(uint8_t type, int value);
	private:
		void dispatcher(uint8_t type, int value);
		void reportHid();

		Fifo mFifo;
		Hid *mHid;
		Interpreter *mInterpreter;
		unsigned long mLastReportTime;
};


#endif 
