heqichen/qc40/andon/src/keymap.h

#ifndef __KEYMAP_H__
#define __KEYMAP_H__

#include <stdint.h>

extern uint32_t myLayout[][48];

#define H4K_LAYOUT(\
K24,K25,K26,K27,K28,K29,K30,K31,K41,K42,K43,K44,K45,\
K16,K17,K18,K19,K20,K21,K22,K23,K34,K33,K40,K32,\
K8,K9,K10,K11,K12,K13,K14,K15,K38,K37,K36,K35,\
K0,K1,K2,K4,K5,K6,K7,K3,K39,\
K46,K47)\
K0, K1, K2, K3, K4, K5, K6, K7, K8, K9,\
K10, K11, K12, K13, K14, K15, K16, K17, K18, K19,\
K20, K21, K22, K23, K24, K25, K26, K27, K28, K29,\
K30, K31, K32, K33, K34, K35, K36, K37, K38, K39,\
K40, K41, K42, K43, K44, K45, K46, K47



#endif
