heqichen/qc40/(commit log)

2017-07-25 add stm32 program skeleton
2017-07-25 update makefile to flash program to stm32
2017-07-25 can flash to stm32
2017-07-25 now can show usb device on host
2017-07-26 add andon using standard perihohph library
    [STM3210B-EVAL_Custom.cfg, STM3210E-EVAL_HD.cfg, STM32L152-EVAL_custom.cfg]
2017-07-26 can simulate usb device
2017-07-27 stm32 core circuit and keyboard
    [h4k1.brd, h4k1.sch]
2017-07-28 add usb hub
    [h4k1.brd, h4k1.sch]
2017-07-29 audio done
    [h4k1.brd, h4k1.sch]
2017-07-29 add usb connector
    [h4k1.brd, h4k1.sch]
2017-07-29 add switches
    [h4k1.brd, h4k1.sch]
2017-07-29 WIP: layout keyboard switches
    [h4k1.brd, h4k1.sch]
2017-07-30 re-layout keyboard switch
    [h4k1.brd]
2017-07-30 stm32 layout done
    [h4k1.brd, h4k1.sch]
2017-07-30 layout without led
    [h4k1.brd, h4k1.sch]
2017-07-30 WIP: led layout
    [h4k1.brd, h4k1.sch]
2017-07-31 update keyboard layout
    [h4k1.brd]
2017-07-31 keyboard layout done not checked
    [h4k1.brd]
2017-07-31 resolve drc problem
    [h4k1.brd, h4k1.sch]
2017-07-31 layout done
    [h4k1.brd, h4k1.sch]
2017-07-31 add mounting holes
    [h4k1.brd, h4k1.sch]
2017-07-31 generate v0.1 gerber files
    [h4k1.GBL, h4k1.GBO, h4k1.GBP, h4k1.GBS, h4k1.GTL, h4k1.GTO, h4k1.GTP, h4k1.GTS]
2017-08-14 update keybord for gl850 not limit power usage
    [h4k1.brd, h4k1.sch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]
2017-08-15 add usb pull up resistor
    [h4k1.brd, h4k1.sch]
2017-08-16 update i2c and serial library
2017-08-16 WIP: read data from i2c1
2017-08-16 using hqc bmx055
    [h4k1.brd, h4k1.sch]
2017-08-17 update circuit
    [h4k1.brd, h4k1.sch]
2017-08-17 layout 74138
    [h4k1.brd]
2017-08-17 add serial port
    [h4k1.brd, h4k1.sch]
2017-08-18 add vbus sense circuit
    [h4k1.brd, h4k1.sch]
2017-08-18 add usb disconnect pin
    [h4k1.brd, h4k1.sch]
2017-08-18 fix audio jack problem
    [h4k1.brd, h4k1.sch]
2017-08-18 optimize audio filter circuit
    [h4k1.brd, h4k1.sch]
2017-08-18 place device name
    [h4k1.brd, h4k1.sch]
2017-08-18 optimize circuit
    [h4k1.brd]
2017-08-18 generate v0.2 gerber files
    [h4k1.GBL, h4k1.GBO, h4k1.GBP, h4k1.GBS, h4k1.GTL, h4k1.GTO, h4k1.GTP, h4k1.GTS]
2017-08-19 add transistor label
    [h4k1.brd, h4k1.sch]
2017-08-23 add keyboard upper cover
    [h4k1.dxf]
2017-08-30 add pcm2704 schematic
2017-08-31 add laser cut file
    [print-20170824.dxf]
2018-02-17 add shell cad
    [shell.dxf]
2018-02-18 update shell
    [shell-backup1.fcstd, shell-backup2.fcstd, shell-backup3.fcstd, shell-backup4.fcstd, shell-backup5.fcstd, shell-backup6.fcstd, shell-left.stl, shell-right.stl]
2020-07-28 change file mode after moving to windows
    [STM3210B-EVAL_Custom.cfg, STM3210E-EVAL_HD.cfg, STM32L152-EVAL_custom.cfg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]
